jolianjij/robofield/hardware/field/out/camera_pi_mount.png

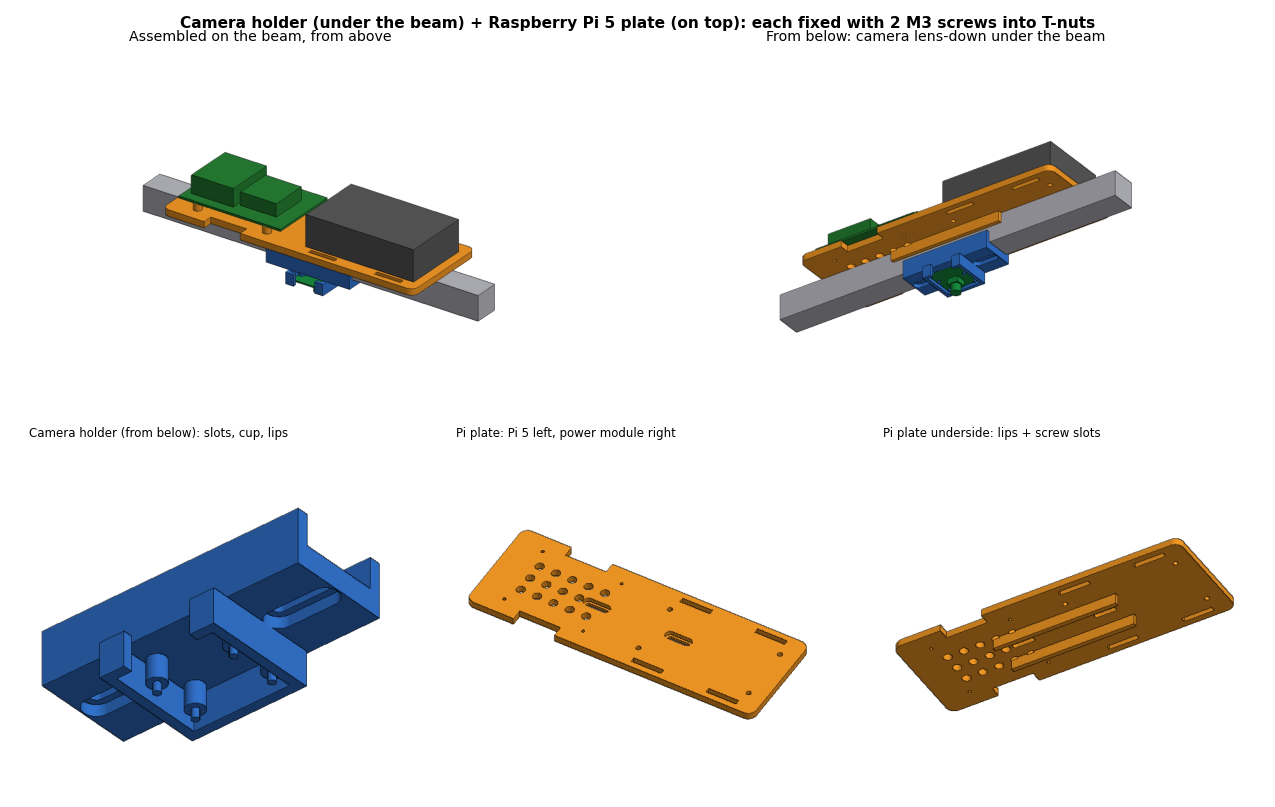
hardware/field/out/camera_pi_mount.png
