jolianjij/robofield/hardware/field/out/views_brace_anchor.png

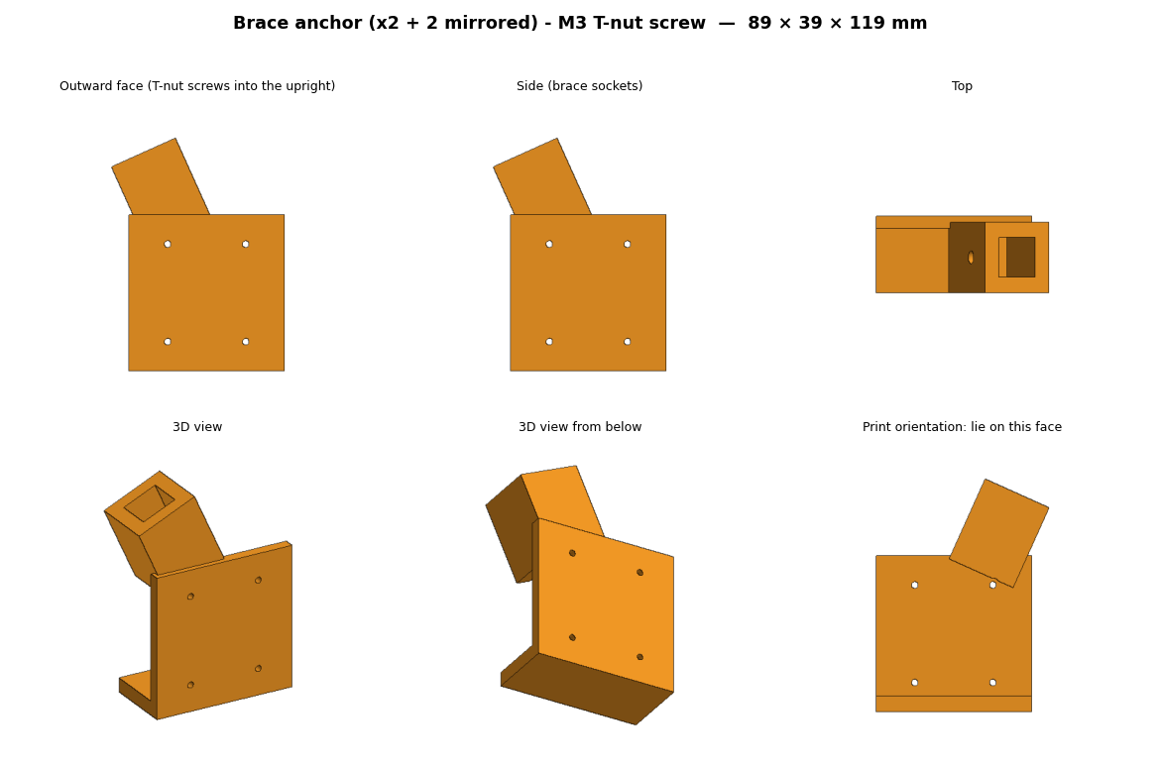
hardware/field/out/views_brace_anchor.png
