jolianjij/robofield/hardware/field/out/views_brace_clamp.png

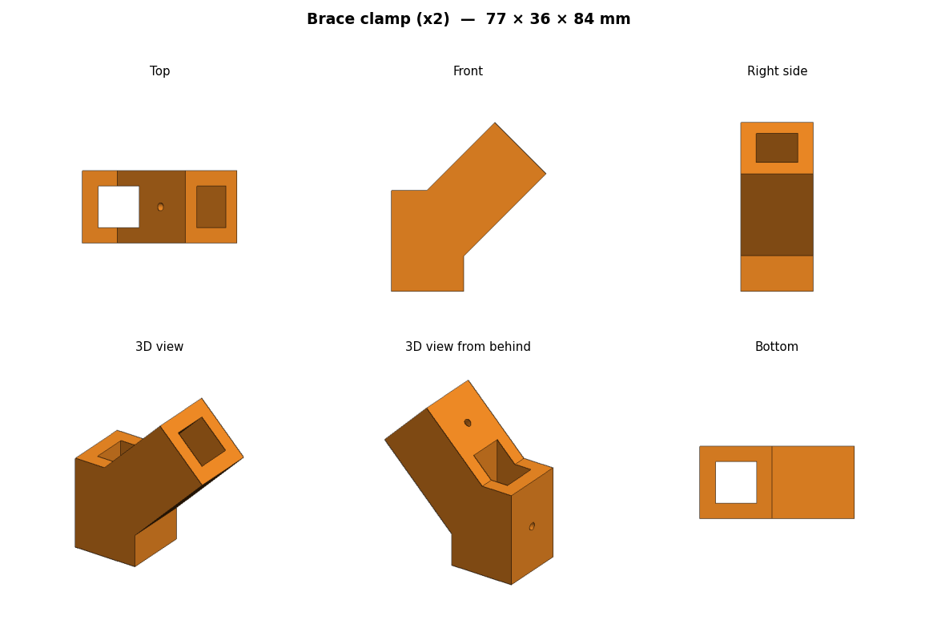
hardware/field/out/views_brace_clamp.png
