jolianjij/robofield/hardware/field/out/views_brace_clamp_double.png

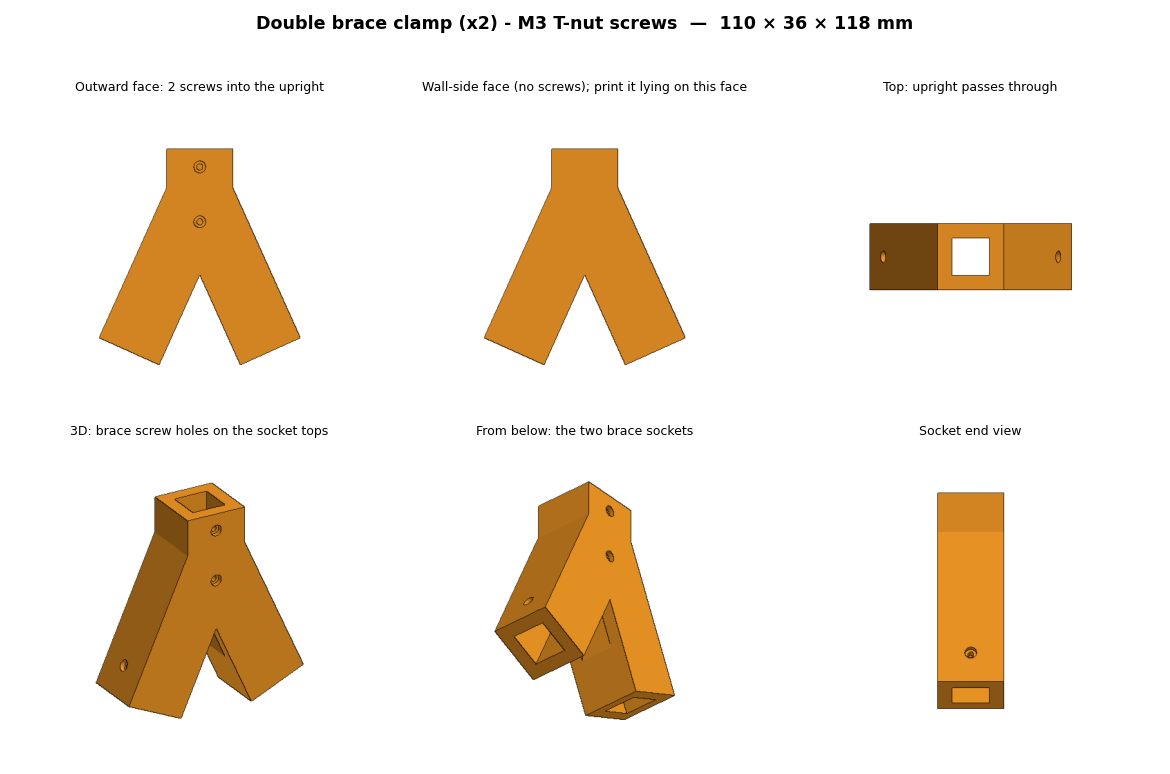
hardware/field/out/views_brace_clamp_double.png
