jolianjij/robofield/hardware/field/out/views_camera_holder.png

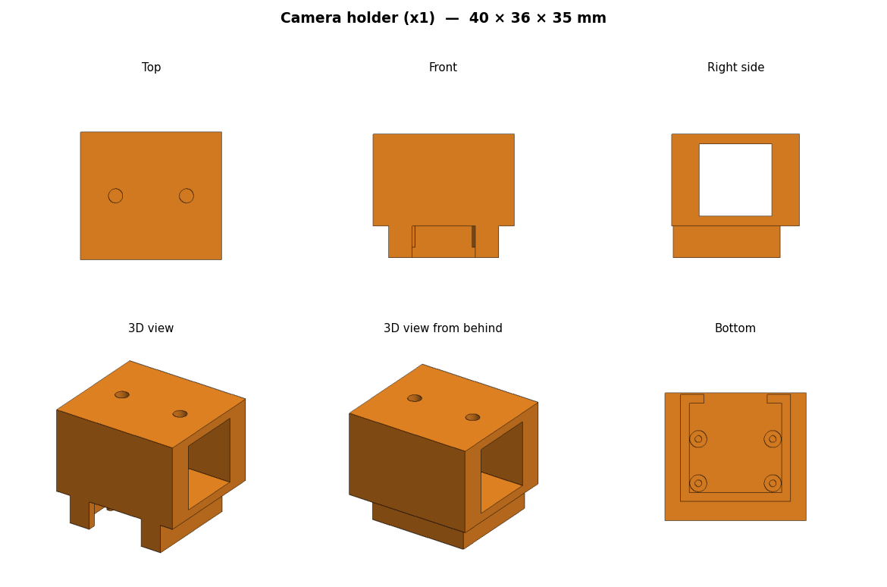
hardware/field/out/views_camera_holder.png
