jolianjij/robofield/hardware/field/out/views_mast_clamp.png

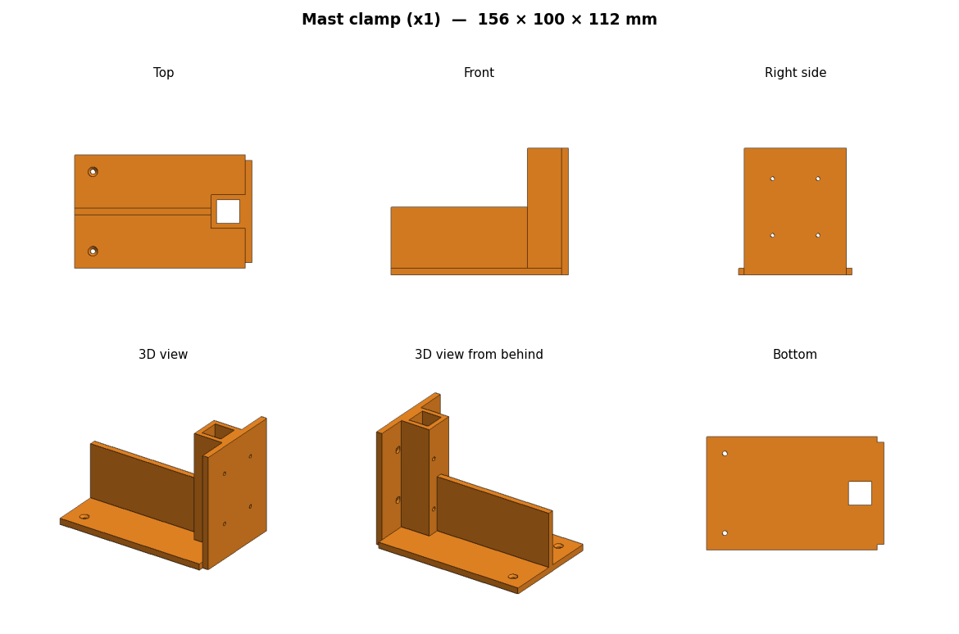
hardware/field/out/views_mast_clamp.png
