jolianjij/robofield/hardware/field/out/views_mast_clamp_tall.png

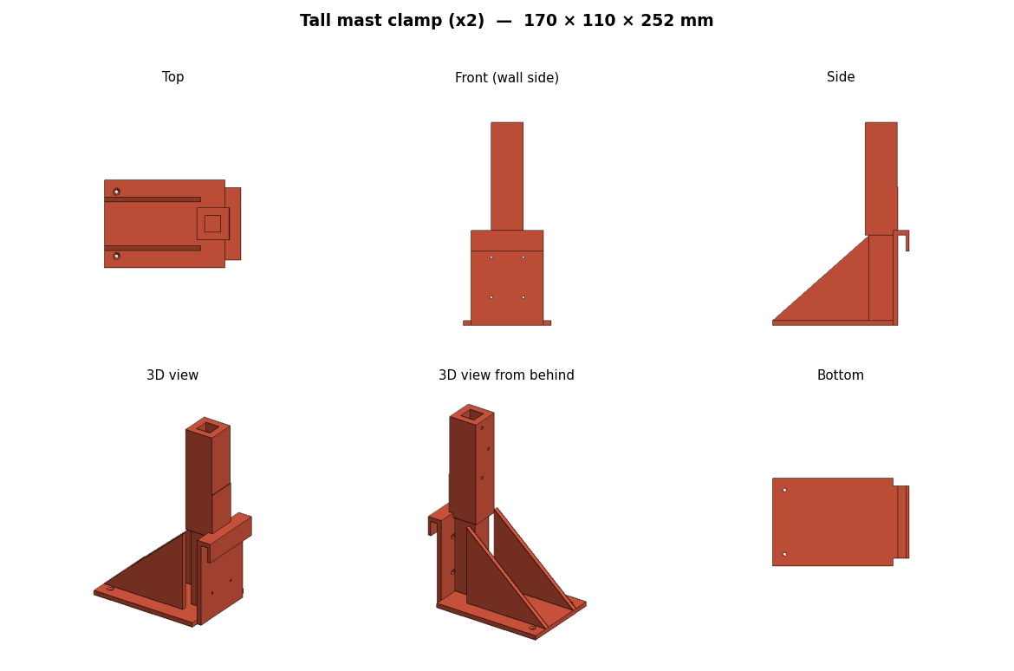
hardware/field/out/views_mast_clamp_tall.png
