jolianjij/robofield/hardware/field/out/views_splice_plate.png

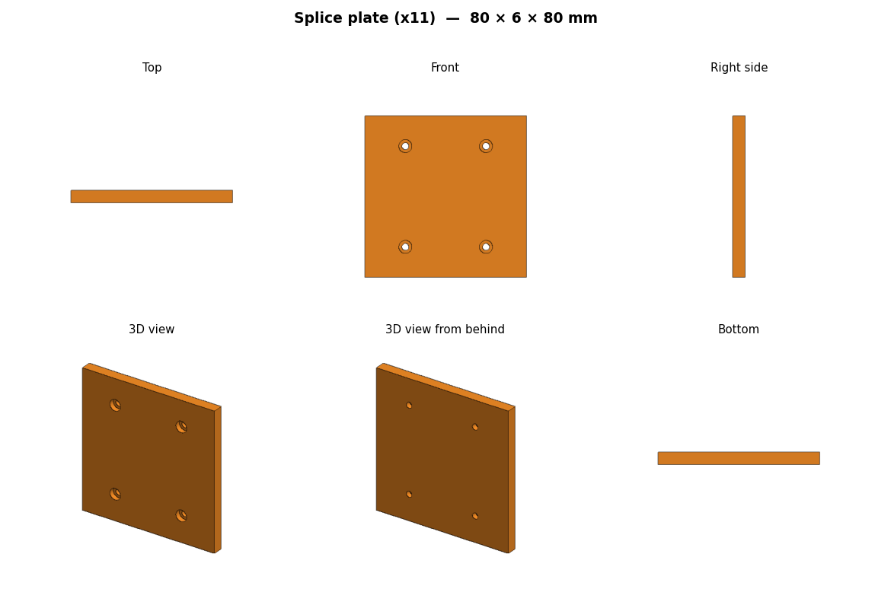
hardware/field/out/views_splice_plate.png
