jolianjij/robofield/hardware/field/out/views_tower_base.png

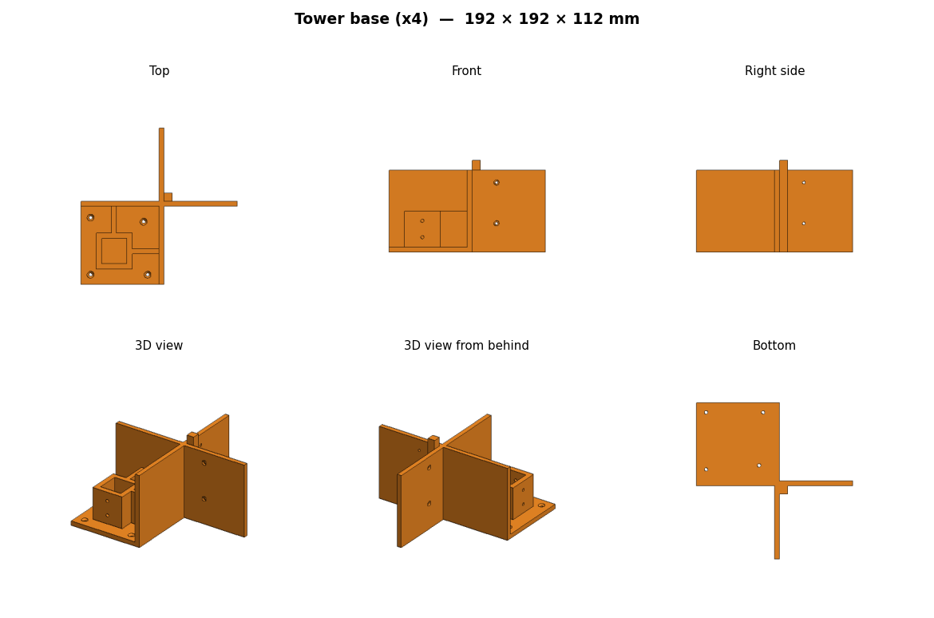
hardware/field/out/views_tower_base.png
