jolianjij/robofield/hardware/field/out/views_tower_cap.png

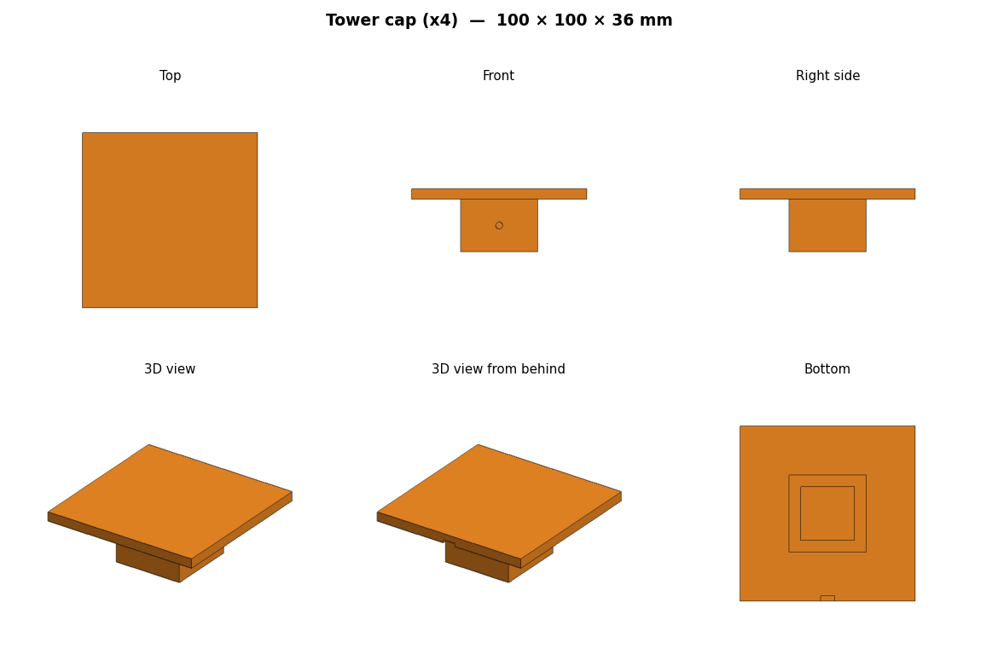
hardware/field/out/views_tower_cap.png
