jolianjij/robofield/hardware/field/out/views_wall_module.png

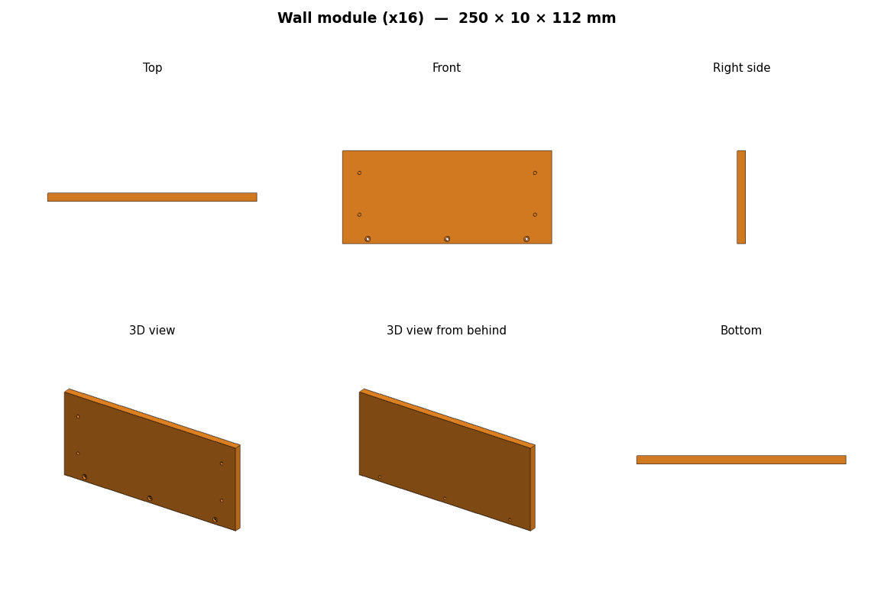
hardware/field/out/views_wall_module.png
