jolianjij/robofield/hardware/field/preview_braced_mast.png

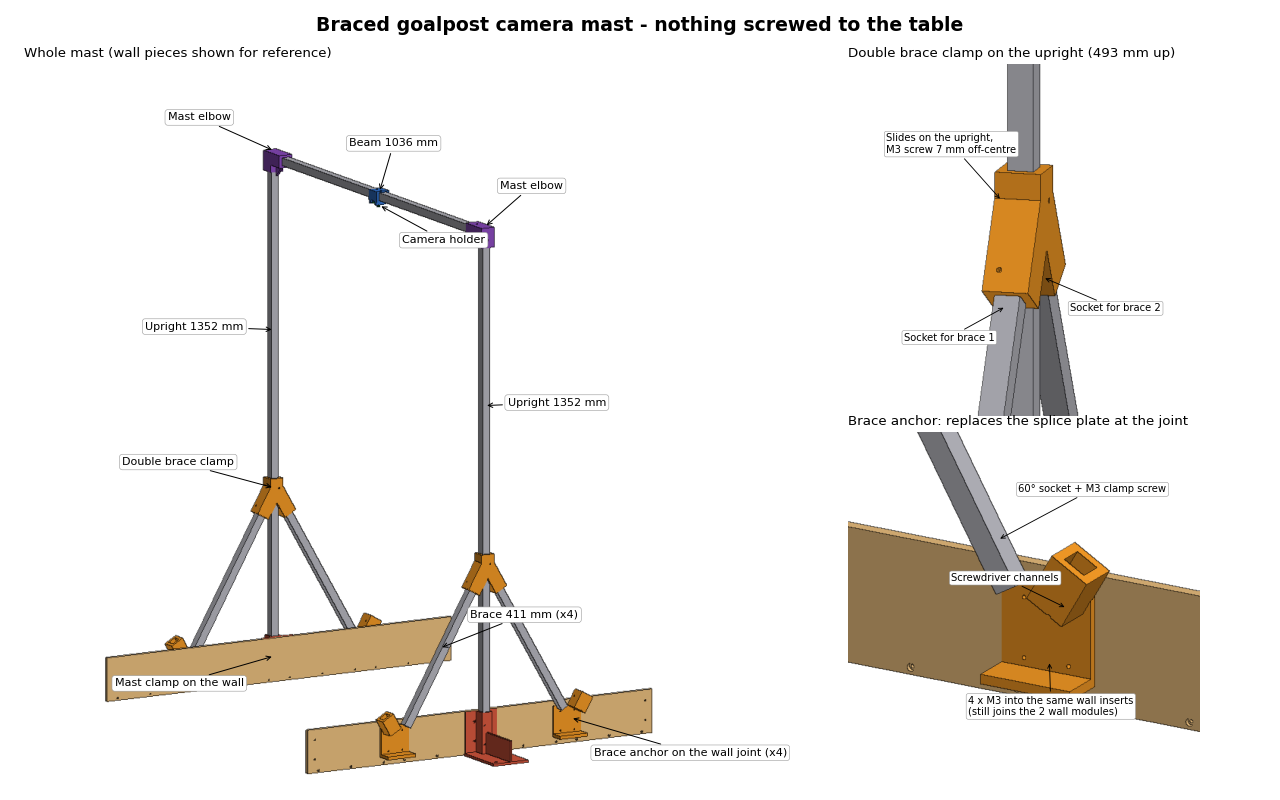
hardware/field/preview_braced_mast.png
