jolianjij/robofield/hardware/field/preview_camera_holder.png

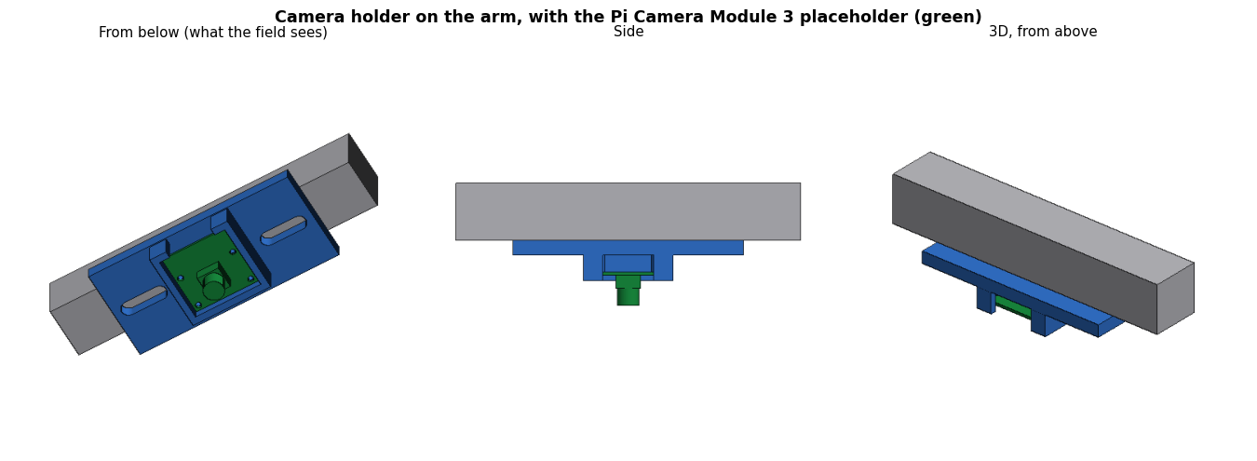
hardware/field/preview_camera_holder.png
