jolianjij/robofield/hardware/field/preview_camera_mast.png

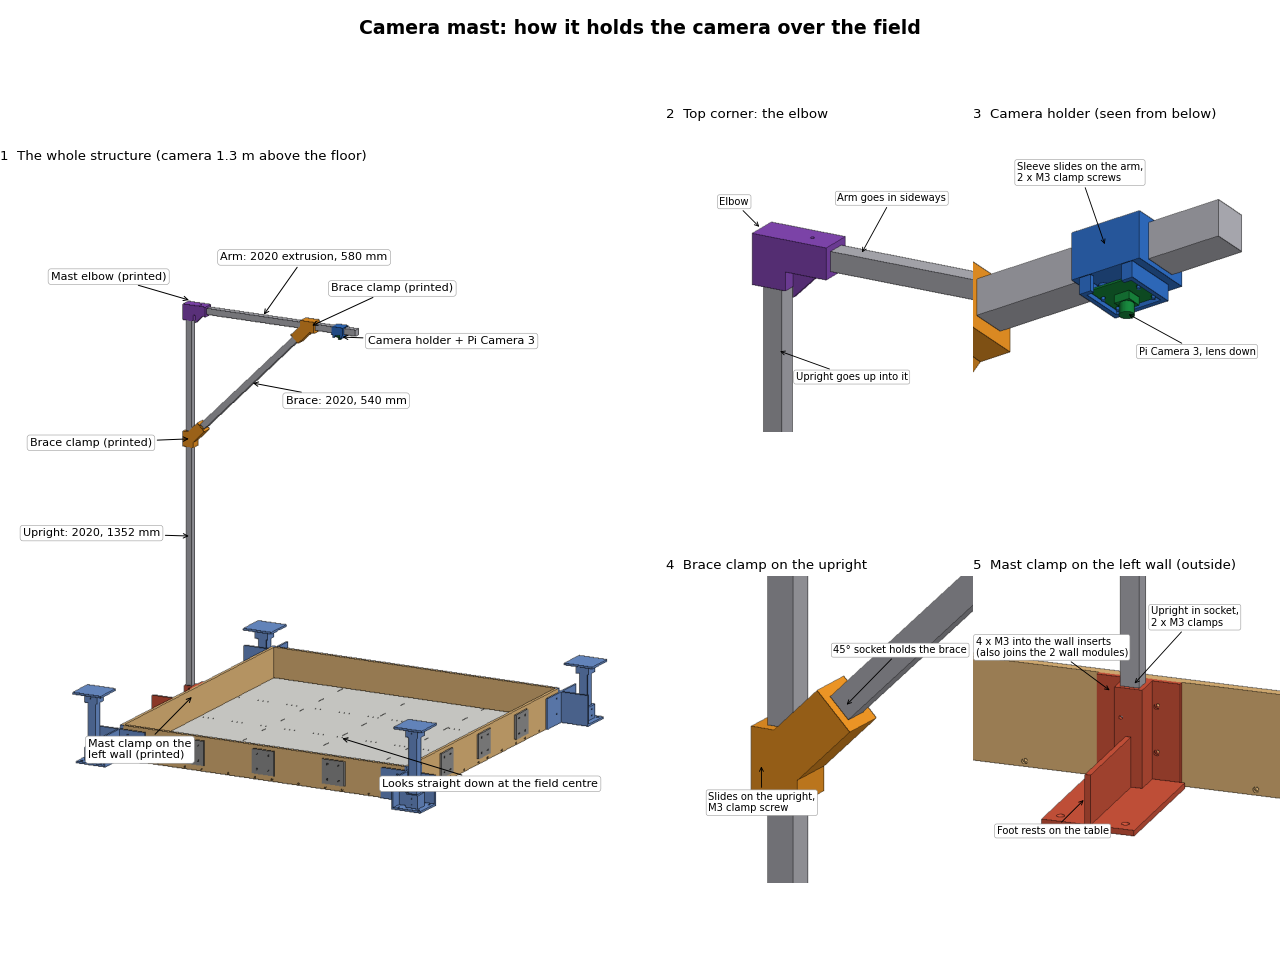
hardware/field/preview_camera_mast.png
