jolianjij/robofield/hardware/field/preview_goalpost_mast.png

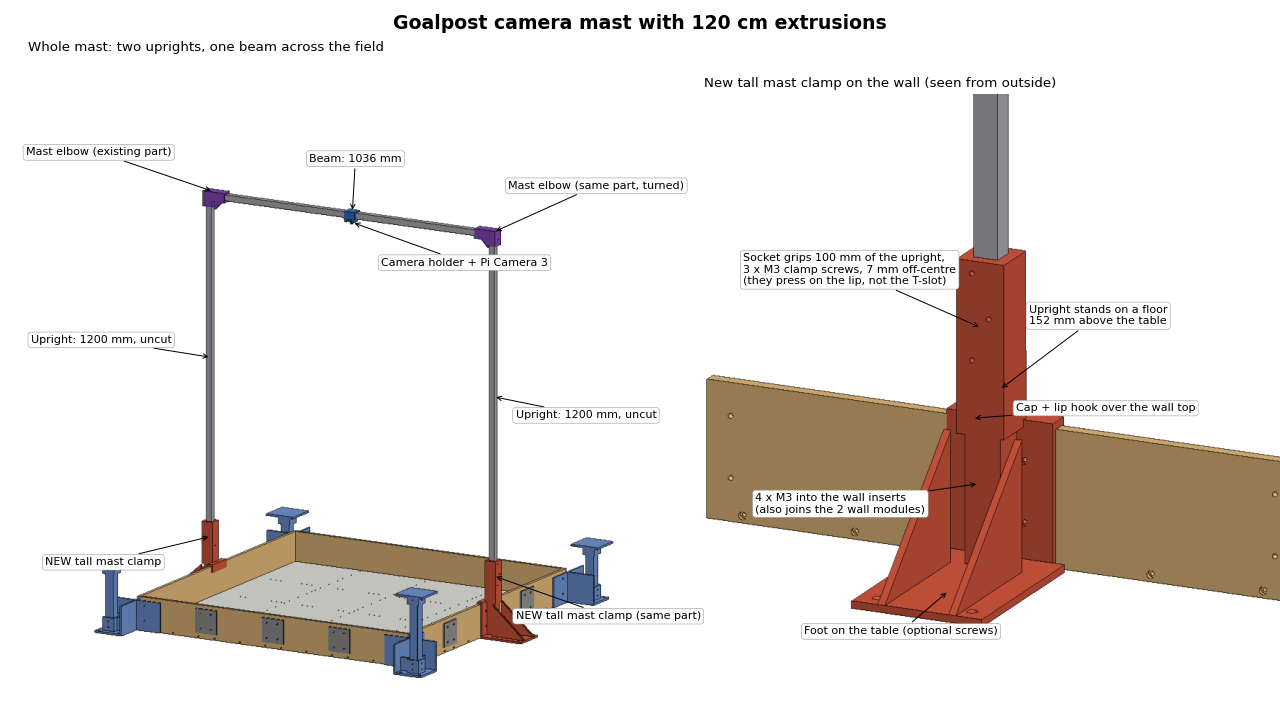
hardware/field/preview_goalpost_mast.png
