jolianjij/robofield/hardware/field/preview_mast.png

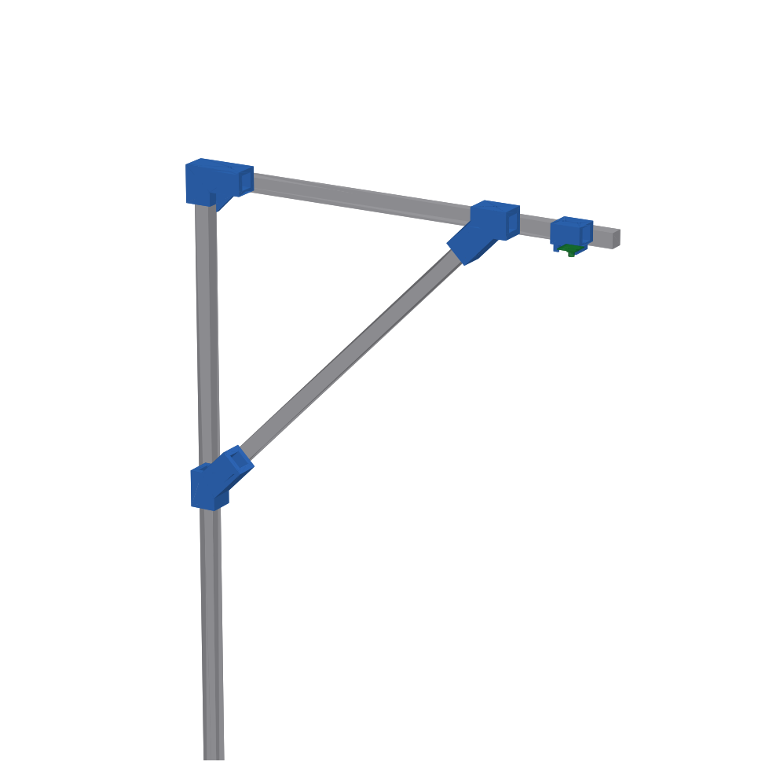
hardware/field/preview_mast.png
