jolianjij/robofield/hardware/field/preview_mast_clamp.png

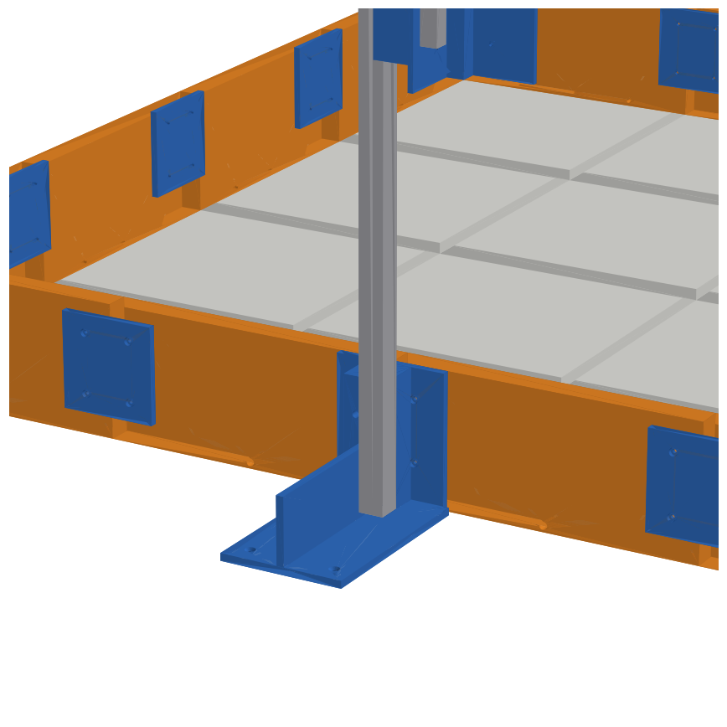
hardware/field/preview_mast_clamp.png
