jolianjij/robofield/hardware/field/preview_tower.png

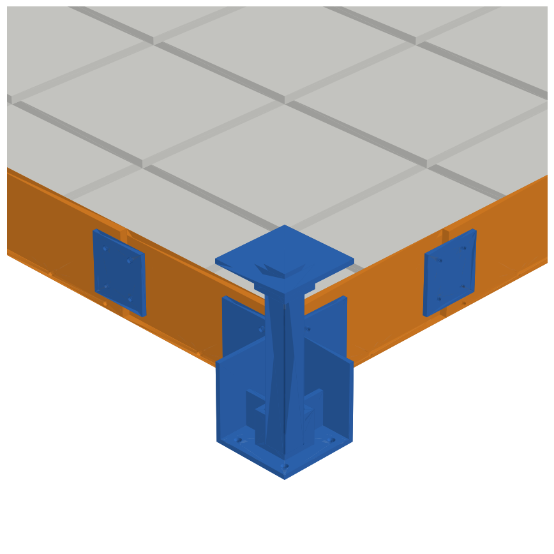
hardware/field/preview_tower.png
