jolianjij/robofield/hardware/field/out/camera_pi_mount_assembly.step

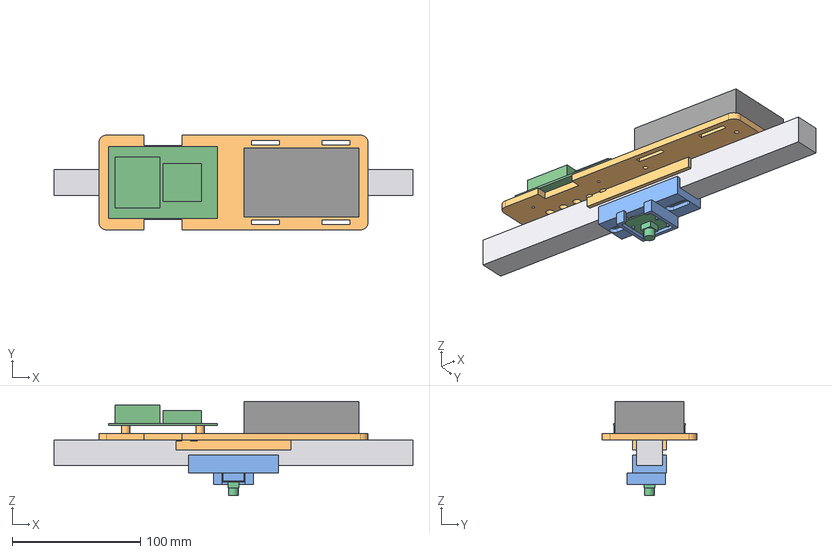
[picture p21: CAD file, 2026-11-05]
hardware/field/out/camera_pi_mount_assembly.step
280.0 x 74.0 x 73.5 mm
beam_2020
camera_holder_beam
pi_camera_module3
pi5_top_plate
pi5_spacer_-1_-1
pi5_spacer_-1_1
pi5_spacer_1_-1
pi5_spacer_1_1
raspberry_pi5_placeholder
power_module_placeholder
