jolianjij/robofield/hardware/field/out/mast_goalpost_assembly.step

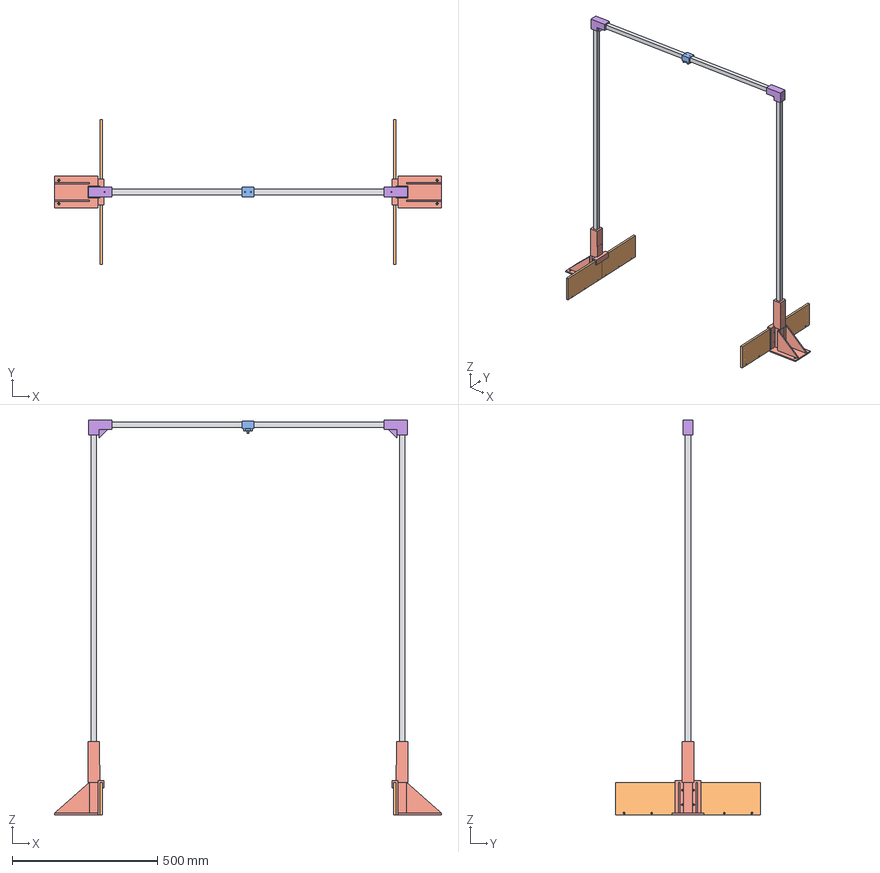
[picture p22: CAD file, 2026-11-05]
hardware/field/out/mast_goalpost_assembly.step
1332.0 x 500.0 x 1358.5 mm
wall_left_ref_a
wall_left_ref_b
wall_right_ref_a
wall_right_ref_b
mast_clamp_tall_left
mast_clamp_tall_right
upright_left_1200mm
upright_right_1200mm
mast_elbow_left
mast_elbow_right
beam_1036mm
camera_holder
camera_placeholder
