jolianjij/robofield/hardware/field/out/mast_braced_assembly.step

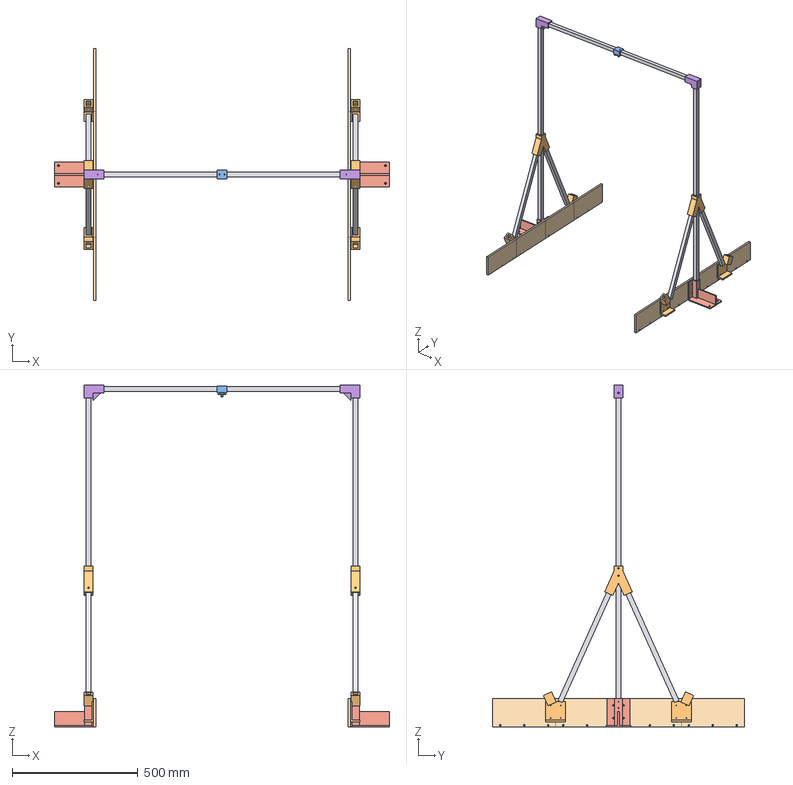
[picture p23: CAD file, 2026-11-05]
hardware/field/out/mast_braced_assembly.step
1332.0 x 1000.0 x 1358.5 mm
wall_ref_0
wall_ref_1
wall_ref_2
wall_ref_3
wall_ref_4
wall_ref_5
wall_ref_6
wall_ref_7
mast_clamp_left
mast_clamp_right
upright_left_1352mm
upright_right_1352mm
mast_elbow_left
mast_elbow_right
beam_1036mm
camera_holder
camera_placeholder
brace_clamp_double_left
brace_anchor_left_y250
brace_left_y250_505mm
brace_anchor_left_y750
brace_left_y750_505mm
brace_clamp_double_right
brace_anchor_right_y250
brace_right_y250_505mm
brace_anchor_right_y750
brace_right_y750_505mm
