jolianjij/robofield/hardware/field/out/field_assembly.step

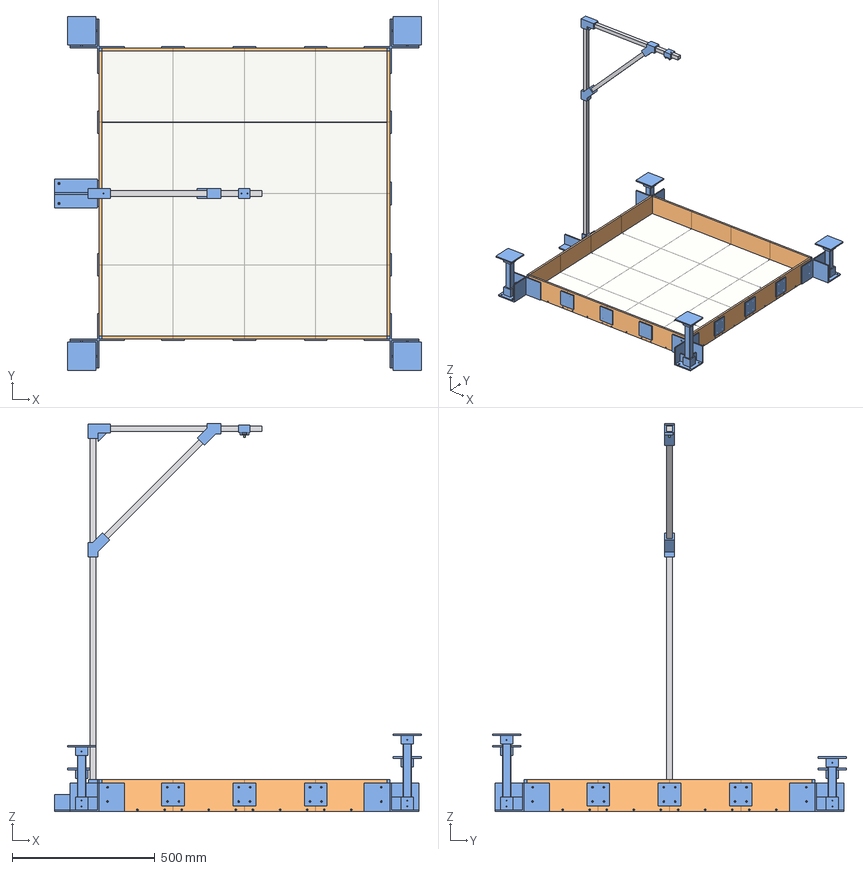
[picture p24: CAD file, 2026-11-05]
hardware/field/out/field_assembly.step
1287.0 x 1242.0 x 1360.5 mm
tile_00
tile_01
tile_02
tile_03
tile_10
tile_11
tile_12
tile_13
tile_20
tile_21
tile_22
tile_23
tile_30
tile_31
tile_32
tile_33
wall_bottom_0
wall_top_0
wall_left_0
wall_right_0
wall_bottom_1
wall_top_1
wall_left_1
wall_right_1
wall_bottom_2
wall_top_2
wall_left_2
wall_right_2
wall_bottom_3
wall_top_3
wall_left_3
wall_right_3
splice_bottom_1
splice_top_1
splice_right_1
splice_left_1
splice_bottom_2
splice_top_2
splice_right_2
splice_bottom_3
splice_top_3
splice_right_3
splice_left_3
T3_base
T3_column_220mm
T3_cap
T4_base
T4_column_260mm
T4_cap
T2_base
T2_column_180mm
T2_cap
T1_base
T1_column_140mm
T1_cap
mast_clamp
mast_upright_2020_1352mm
mast_arm_2020_580mm
mast_elbow
brace_clamp_upright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
