jolianjij/robofield/hardware/field/field_tile_key.step

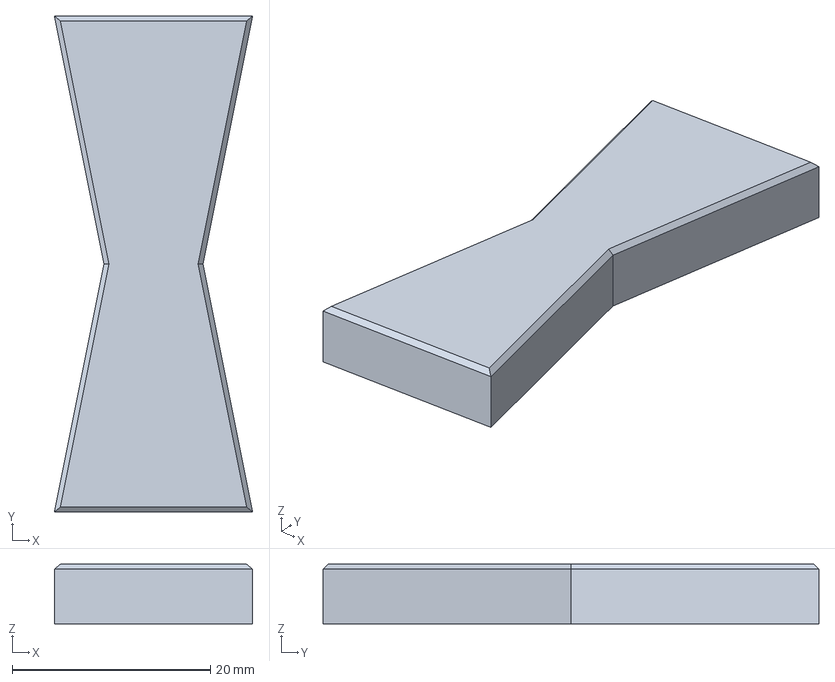
[picture p25: CAD file, 2026-11-05]
hardware/field/field_tile_key.step
20.0 x 50.0 x 6.00 mm
