jolianjij/robofield/hardware/field/out/brace_anchor.step

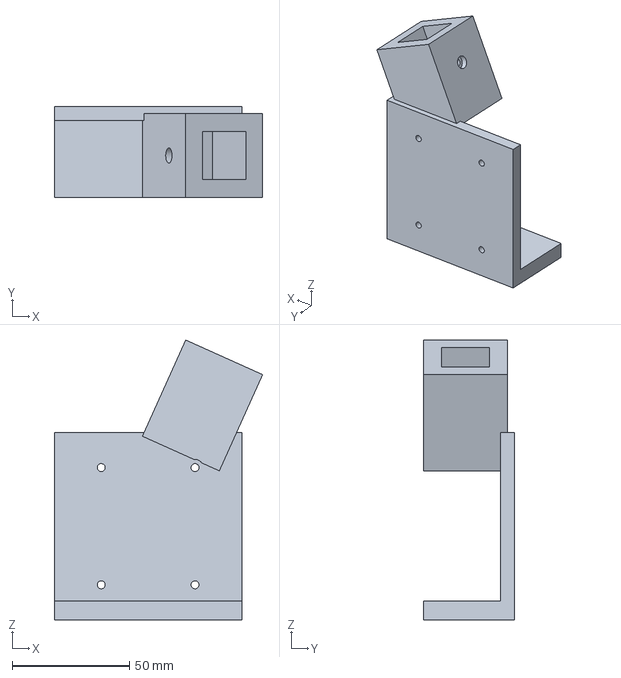
[picture p26: CAD file, 2026-11-05]
hardware/field/out/brace_anchor.step
88.8 x 39.0 x 119.4 mm
