jolianjij/robofield/hardware/field/field_tile_250mm.step

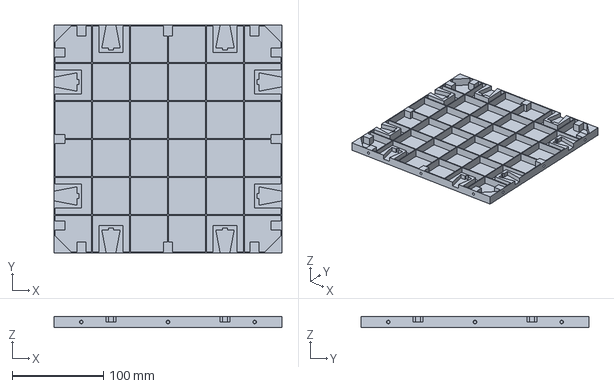
[picture p27: CAD file, 2026-11-05]
hardware/field/field_tile_250mm.step
250.0 x 250.0 x 12.0 mm
