jolianjij/robofield/hardware/field/out/2020_goalpost_beam_1036mm.step

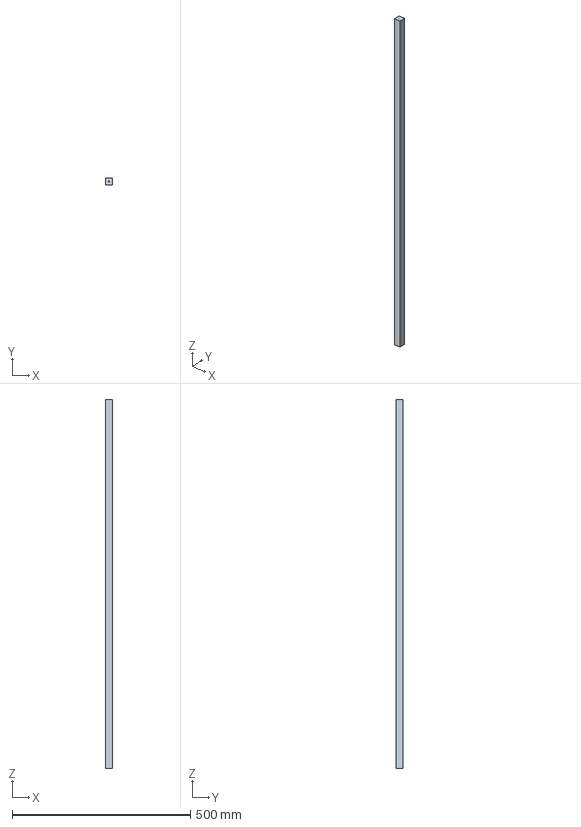
[picture p28: CAD file, 2026-11-05]
hardware/field/out/2020_goalpost_beam_1036mm.step
20.0 x 20.0 x 1036.0 mm
