jolianjij/robofield/hardware/field/field_tile_edge_test_strip.step

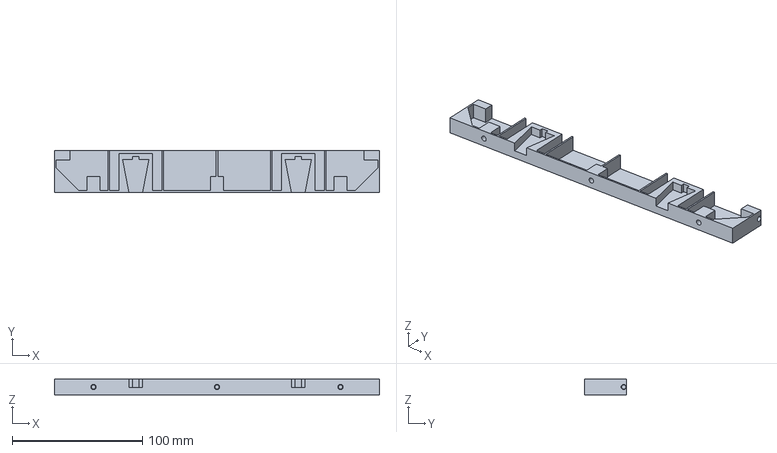
[picture p29: CAD file, 2026-11-05]
hardware/field/field_tile_edge_test_strip.step
250.0 x 32.0 x 12.0 mm
