jolianjij/robofield/hardware/field/out/splice_plate.step

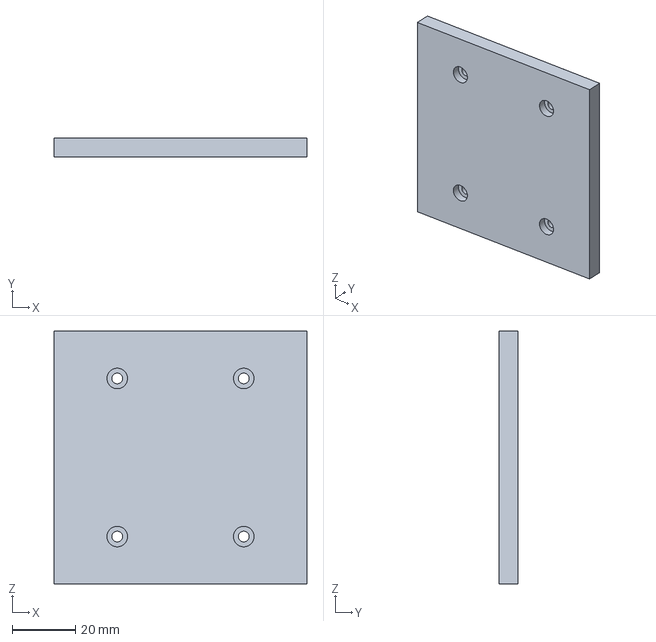
[picture p30: CAD file, 2026-11-05]
hardware/field/out/splice_plate.step
80.0 x 6.00 x 80.0 mm
