jolianjij/robofield/hardware/field/out/2020_goalpost_upright_1200mm.step

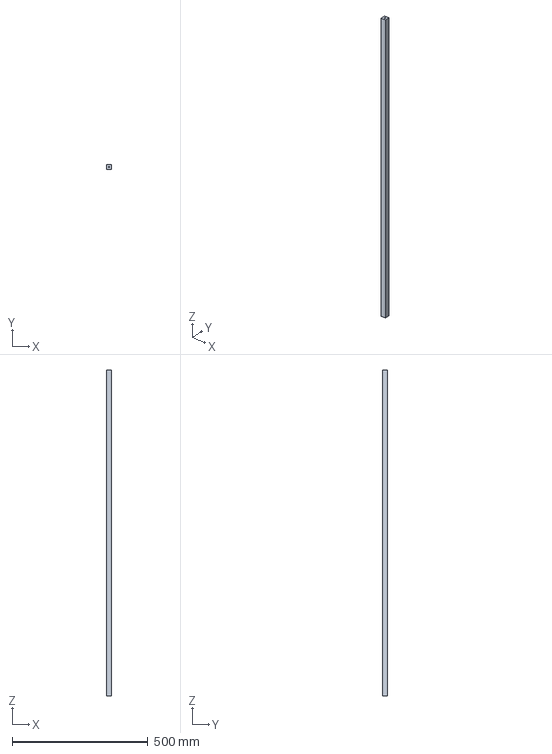
[picture p31: CAD file, 2026-11-05]
hardware/field/out/2020_goalpost_upright_1200mm.step
20.0 x 20.0 x 1200.0 mm
