jolianjij/robofield/hardware/field/out/mast_clamp.step

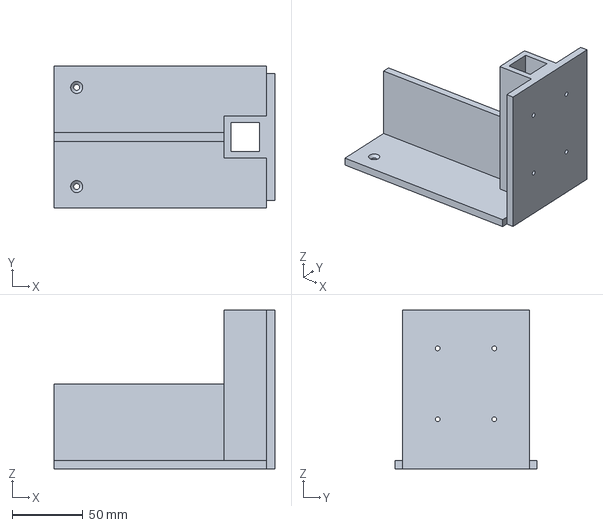
[picture p32: CAD file, 2026-11-05]
hardware/field/out/mast_clamp.step
156.0 x 100.0 x 112.0 mm
