jolianjij/robofield/hardware/field/out/tower_column_T4_260mm.step

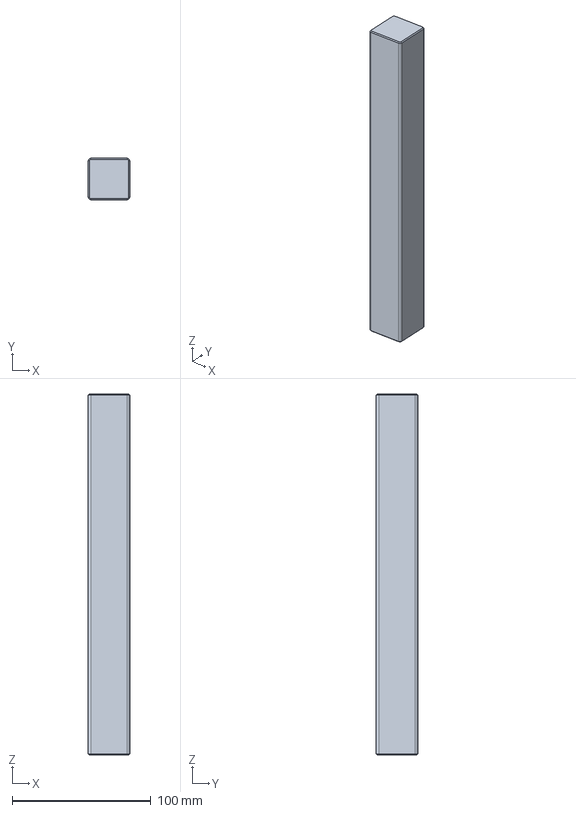
[picture p33: CAD file, 2026-11-05]
hardware/field/out/tower_column_T4_260mm.step
30.0 x 30.0 x 260.0 mm
