jolianjij/robofield/hardware/field/out/2020_upright_1352mm.step

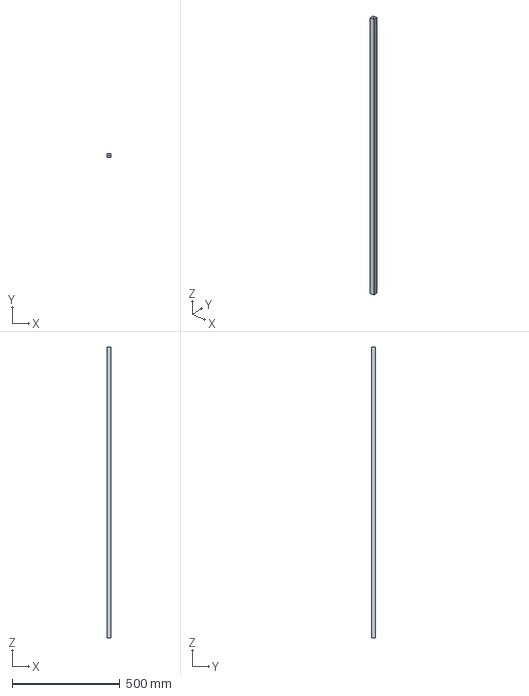
[picture p34: CAD file, 2026-11-05]
hardware/field/out/2020_upright_1352mm.step
20.0 x 20.0 x 1352.5 mm
