jolianjij/robofield/hardware/field/out/tower_column_T1_140mm.step

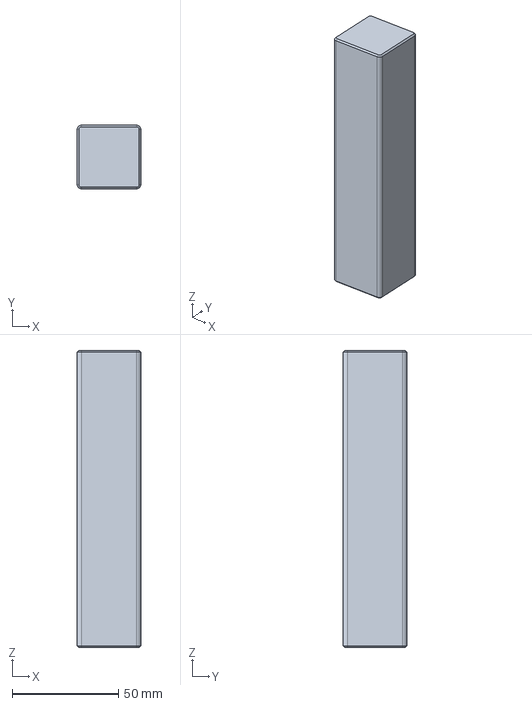
[picture p35: CAD file, 2026-11-05]
hardware/field/out/tower_column_T1_140mm.step
30.0 x 30.0 x 140.0 mm
