jolianjij/robofield/hardware/field/out/mast_elbow.step

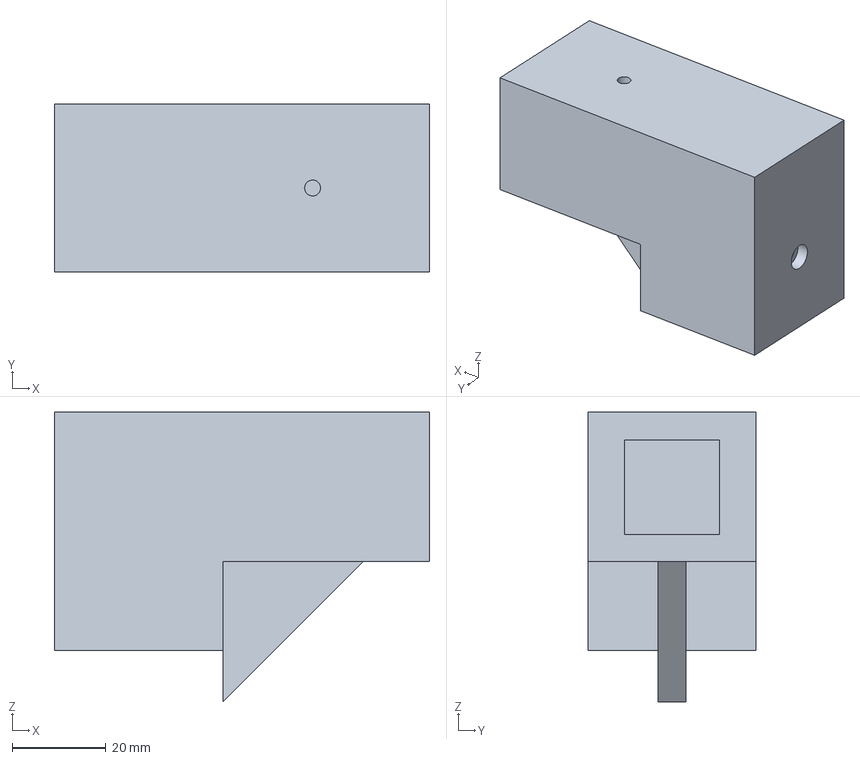
[picture p36: CAD file, 2026-11-05]
hardware/field/out/mast_elbow.step
80.2 x 36.0 x 62.0 mm
