jolianjij/robofield/hardware/field/out/brace_clamp_double.step

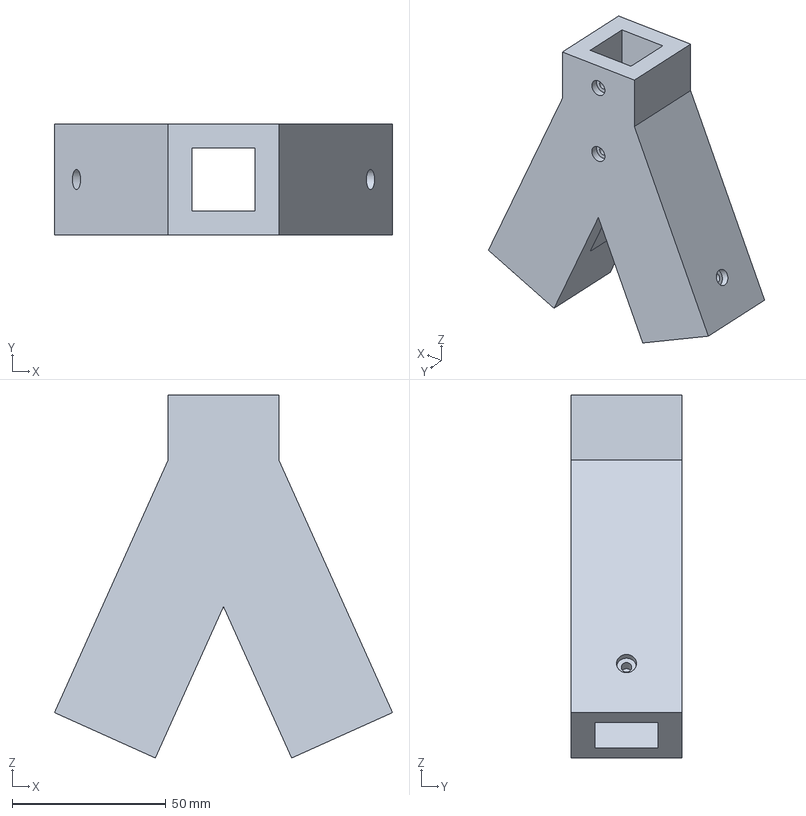
[picture p37: CAD file, 2026-11-05]
hardware/field/out/brace_clamp_double.step
110.0 x 36.0 x 118.1 mm
