jolianjij/robofield/hardware/field/out/camera_holder.step

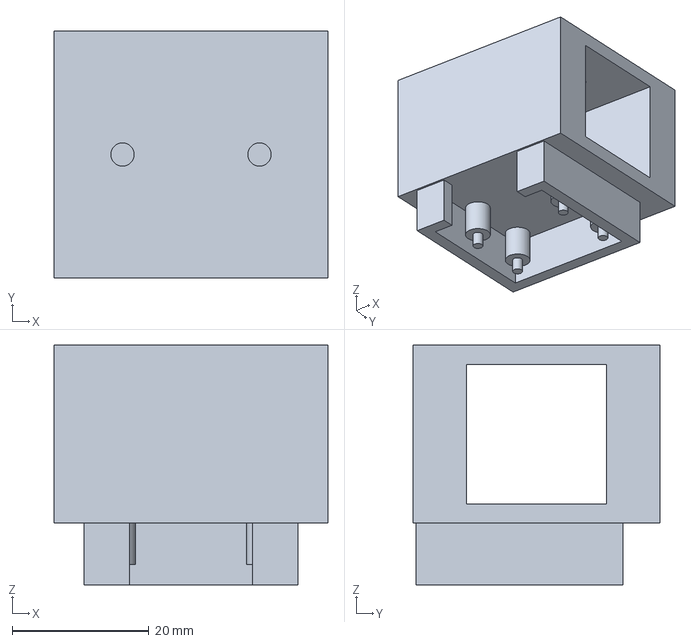
[picture p38: CAD file, 2026-11-05]
hardware/field/out/camera_holder.step
40.0 x 36.0 x 35.0 mm
