jolianjij/robofield/hardware/field/out/2020_brace_505mm.step

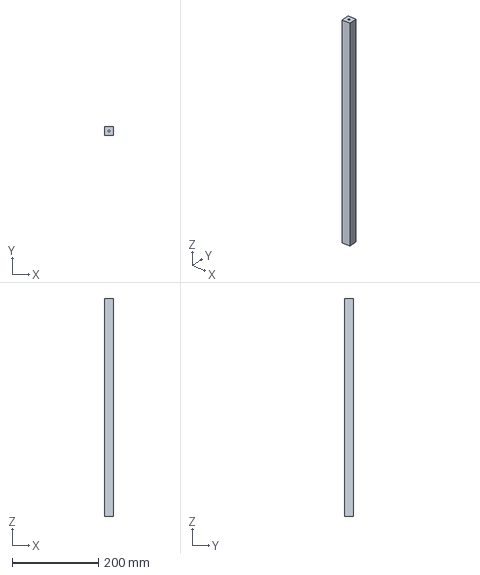
[picture p39: CAD file, 2026-11-05]
hardware/field/out/2020_brace_505mm.step
20.0 x 20.0 x 505.0 mm
