jolianjij/robofield/hardware/field/out/mast_clamp_tall.step

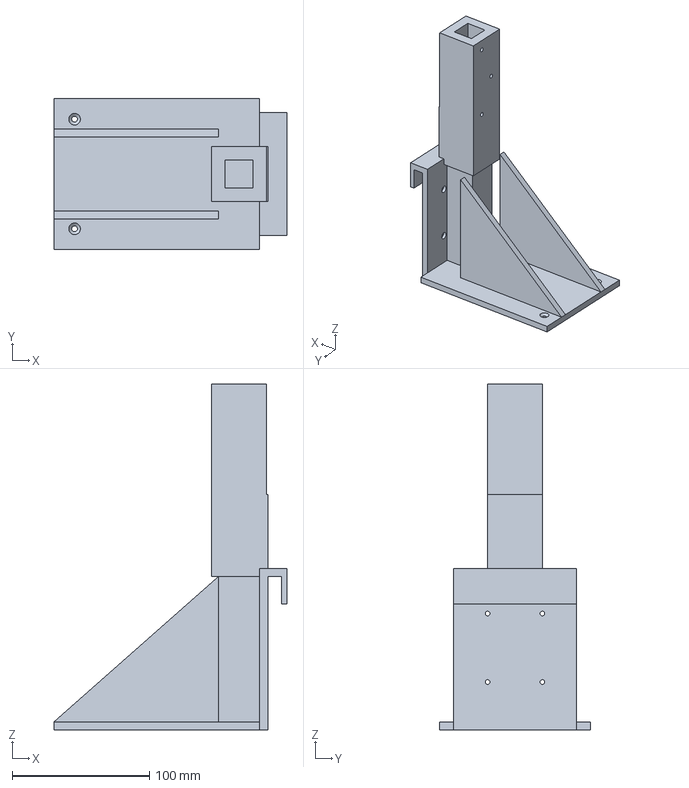
[picture p40: CAD file, 2026-11-05]
hardware/field/out/mast_clamp_tall.step
170.0 x 110.0 x 252.5 mm
