jolianjij/robofield/hardware/field/out/tower_cap.step

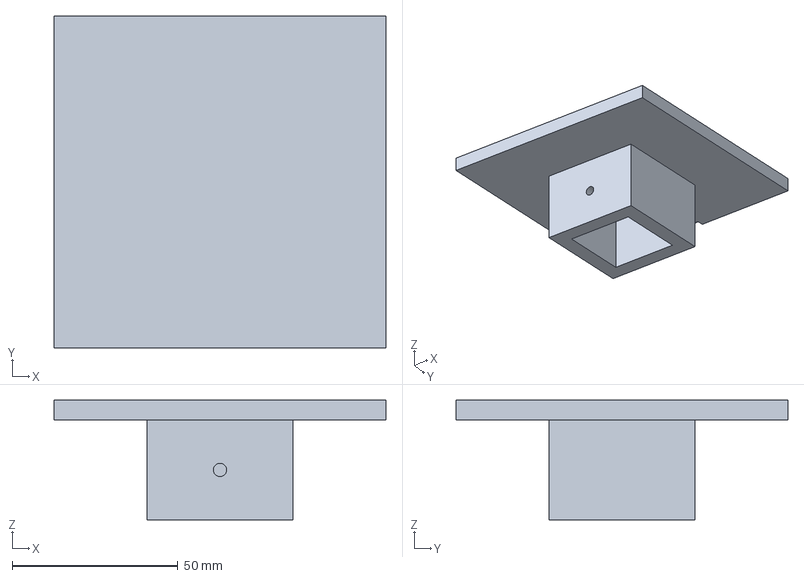
[picture p41: CAD file, 2026-11-05]
hardware/field/out/tower_cap.step
100.0 x 100.0 x 36.0 mm
