jolianjij/robofield/hardware/field/out/pi5_top_plate.step

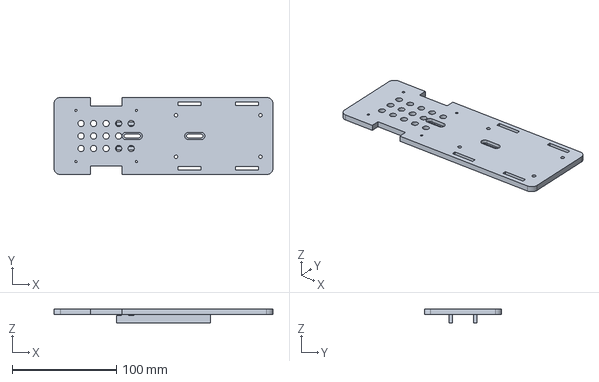
[picture p42: CAD file, 2026-11-05]
hardware/field/out/pi5_top_plate.step
210.0 x 74.0 x 13.0 mm
