jolianjij/robofield/hardware/field/out/wall_module.step

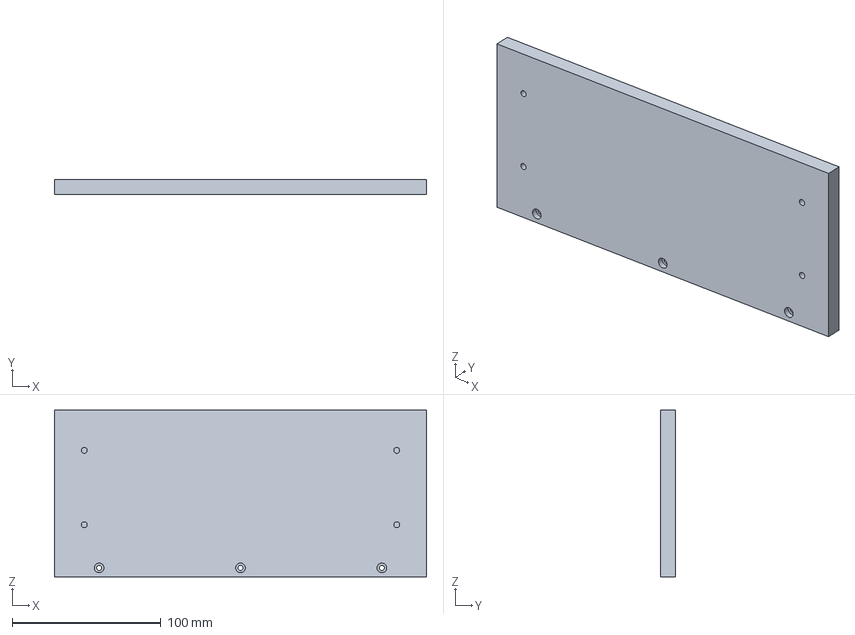
[picture p43: CAD file, 2026-11-05]
hardware/field/out/wall_module.step
250.0 x 10.0 x 112.0 mm
