jolianjij/robofield/hardware/field/out/tower_column_T2_180mm.step

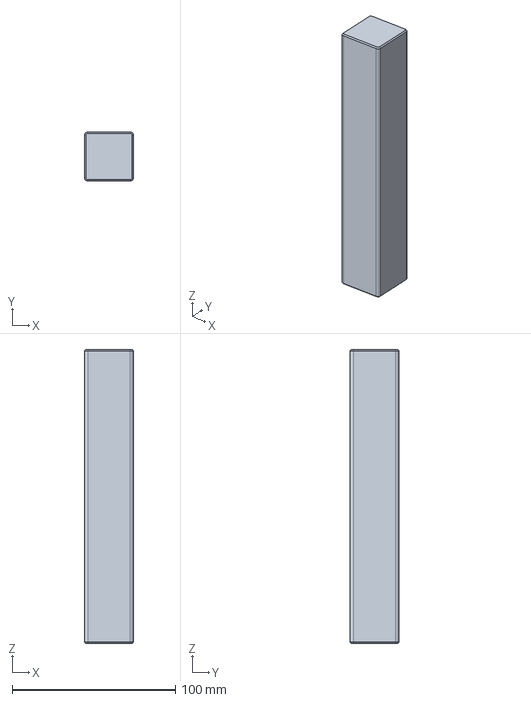
[picture p44: CAD file, 2026-11-05]
hardware/field/out/tower_column_T2_180mm.step
30.0 x 30.0 x 180.0 mm
