jolianjij/robofield/hardware/field/out/pi5_spacer.step

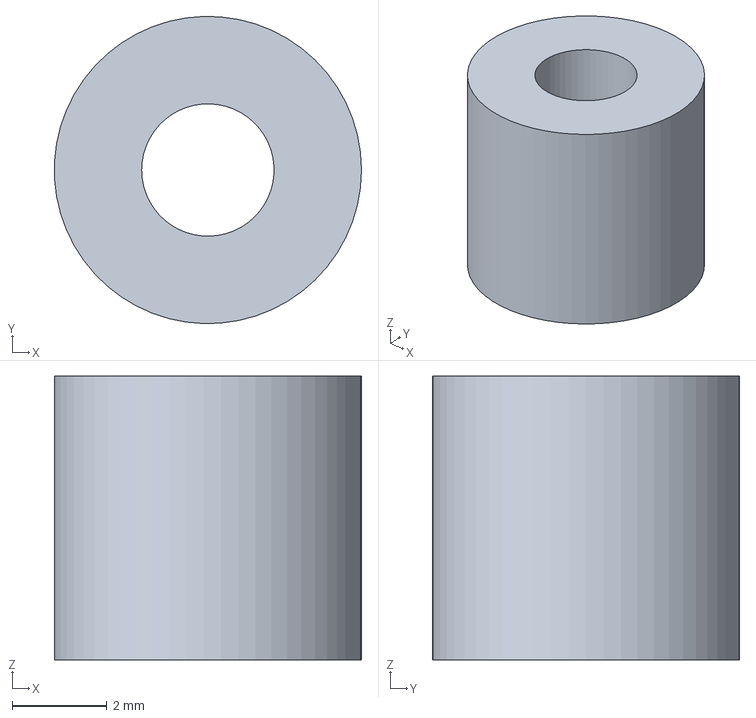
[picture p45: CAD file, 2026-11-05]
hardware/field/out/pi5_spacer.step
6.49 x 6.50 x 6.00 mm
