jolianjij/robofield/hardware/field/out/brace_clamp.step

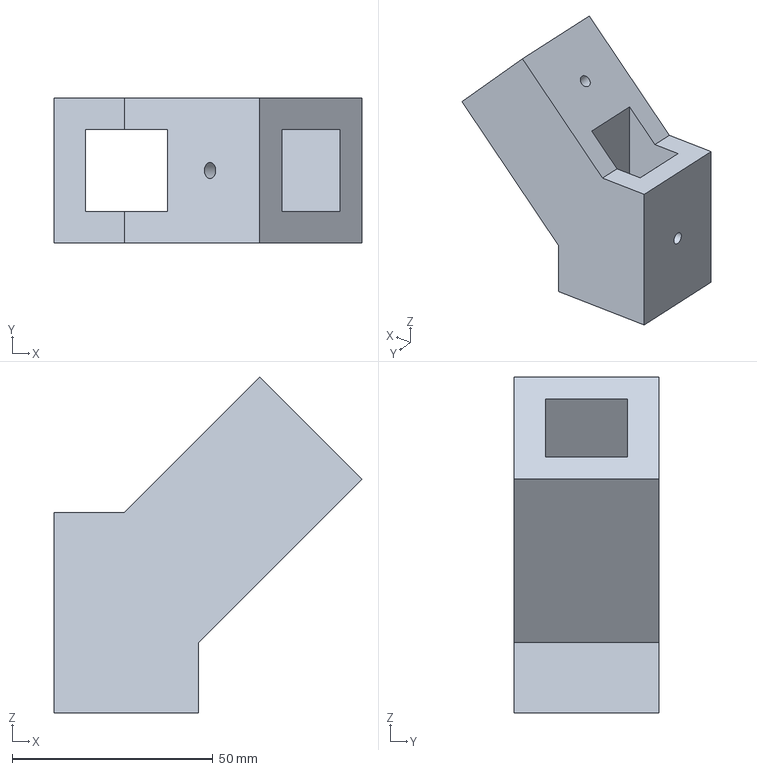
[picture p46: CAD file, 2026-11-05]
hardware/field/out/brace_clamp.step
76.7 x 36.0 x 83.7 mm
