jolianjij/robofield/hardware/field/out/camera_pi_module3_placeholder.step

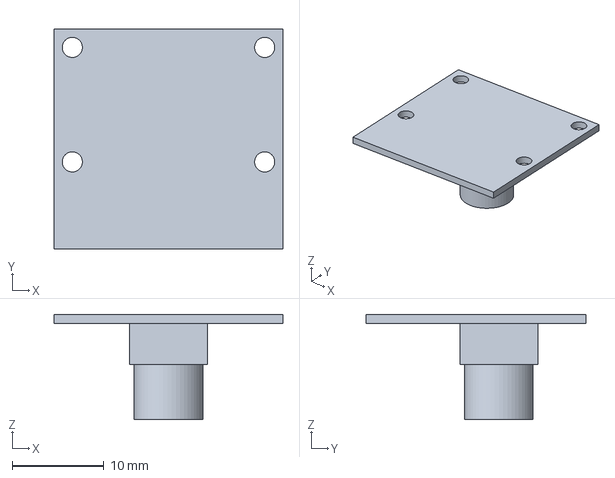
[picture p47: CAD file, 2026-11-05]
hardware/field/out/camera_pi_module3_placeholder.step
25.0 x 24.0 x 11.5 mm
