jolianjij/robofield/hardware/field/out/tower_column_T3_220mm.step

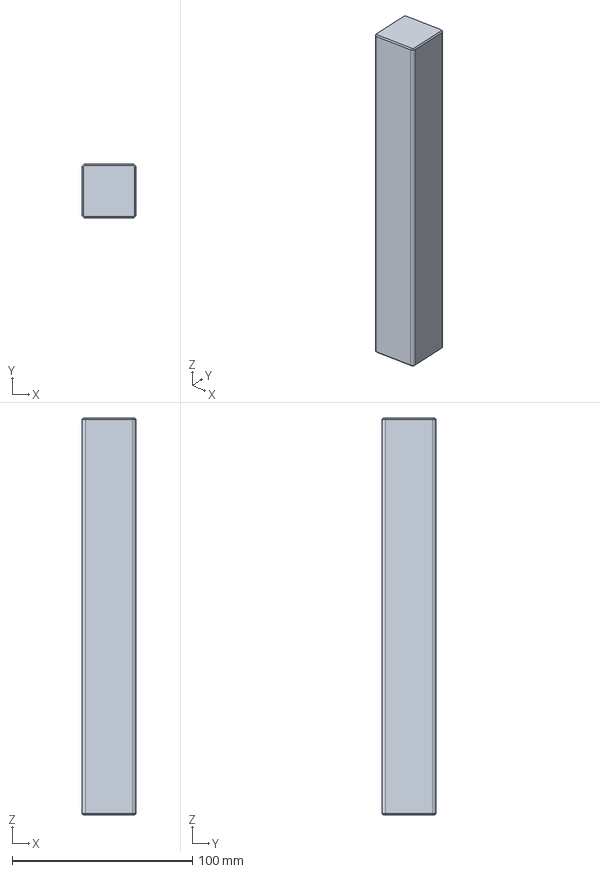
[picture p48: CAD file, 2026-11-05]
hardware/field/out/tower_column_T3_220mm.step
30.0 x 30.0 x 220.0 mm
