jolianjij/robofield/hardware/field/out/camera_holder_beam.step

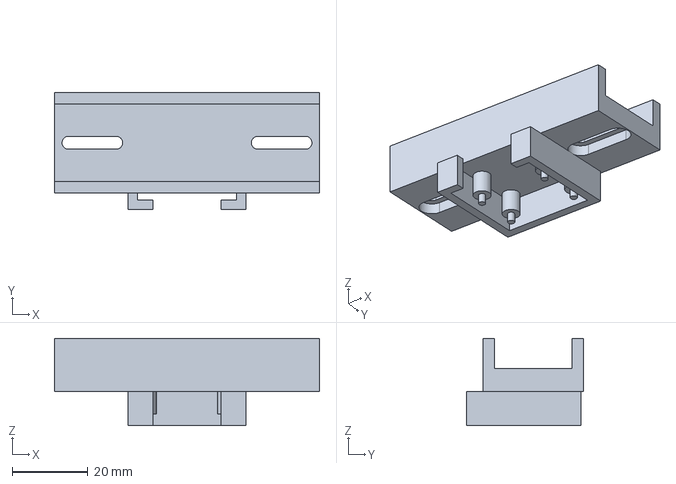
[picture p49: CAD file, 2026-11-05]
hardware/field/out/camera_holder_beam.step
70.0 x 30.9 x 23.0 mm
