jolianjij/robofield/hardware/field/out/tower_base.step

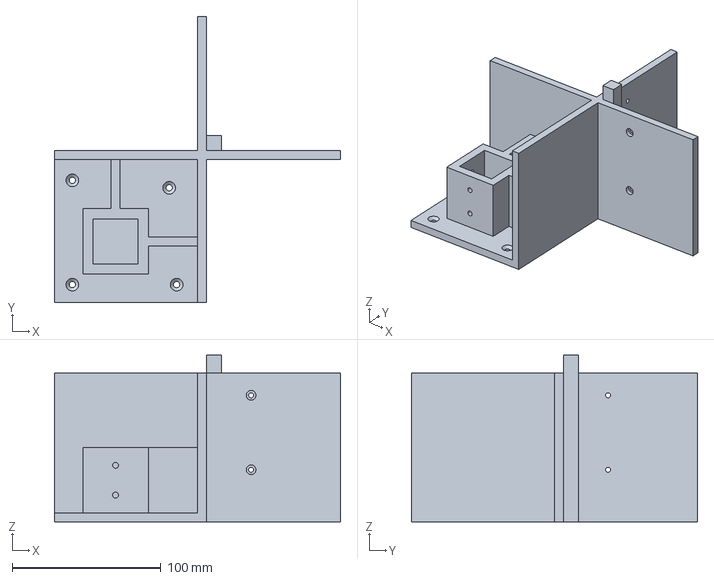
[picture p50: CAD file, 2026-11-05]
hardware/field/out/tower_base.step
192.0 x 192.0 x 112.0 mm
