jolianjij/robofield/(list of files, cad)

Other CAD files:
hardware/field/out/2020_beam_1036mm.step
hardware/field/out/brace_anchor_mirrored.step
hardware/field/field_tile_250mm.stl
hardware/field/field_tile_edge_test_strip.stl
hardware/field/field_tile_key.stl
