jolianjij/robofield/(commit log)

2026-11-05 Initial commit: RoboField/RLCR multi-robot research platform
    Add project context (CLAUDE.md) documenting the real hardware state
    (ESP8266/D1 Mini + DRV8833, replacing the original ESP32-C3/L9110S
    design) and current software stack.
    [2020_beam_1036mm.step, 2020_brace_505mm.step, 2020_goalpost_beam_1036mm.step, 2020_goalpost_upright_1200mm.step, 2020_upright_1352mm.step, brace_anchor.step, brace_anchor_mirrored.step, brace_clamp.step]
2026-11-05 Fix DiffDrive turn-direction sign bug; add PID control, race game, and RL training
    DiffDrive.inverse() had its left/right wheel formulas swapped relative to
    forward(), so every commanded turn rate produced physical rotation in the
    opposite direction. This is the real cause of the "violent oscillation"
    reaching a target orientation: a closed-loop heading controller with an
    inverted sign reinforces whatever rotation already exists instead of
    opposing it, which looks exactly like an undampable limit cycle no matter
    how the gains are tuned. Confirmed against the real car's behavior.
    Also:
    - Enable reverse driving on the final approach and path-following (was
    hardcoded off in PoseController)
    -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
    [field.yaml]
2026-11-06 Turn by pulse-wait-measure pivots; add evaluation and demo tools
    Turning in place on the real car needs a hard kick to break both wheels
    free sideways, then coasts far past the target, so fine corrections were
    impossible and predicted-heading turns stalled short. Turns are now
    single-wheel pivot pulses sized by a learned start-time/turn-rate model,
    each followed by a wait longer than the loop delay before re-measuring.
    Real car: 120 deg turns in ~4 s to within 2-5 deg, no oscillation.
    - tools/eval_motion.py: score straight, turn and curve maneuvers
    - tools/demo.py: wander / figure8 / square demo drives for filming
    - Tuning page: switch back to the old continuous turn to show the difference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
2026-11-06 Document the platform and the control system; add the car firmware
    - README rewritten around what RoboField is and does today, with real-car results
    - docs/control.md: the measured delay and motor data, and how each is handled
    - firmware/car_esp8266: the sketch the cars actually run (secrets.h ignored)
    - CLAUDE.md: current-state section at the top
    - Declare the mujoco dependency as the `sim` extra
2026-11-06 Race from random starts; RL sees the delay-predicted state; camera recorder
    - Race episodes start anywhere across the outer lane, facing any direction
    - RoboFieldEnv(predict=True) observes the same delay-predicted state as the real field
    - Parallel training (one process per env, each with its own randomization seed)
    - Real-car evaluation: speed scale keeps the turn ratio; aligning first is now optional
    - tools/record_camera.py records the Pi preview with its tracking overlay
    A 4M-step policy completes 3 laps from 10/10 random starts in sim (9/10 with
    randomized physics) and completed 3 laps on the real car at 60% speed.
2026-11-06 Saved moves, filming tools, before/after comparison runner
    - Control Center: save a drawn (or sketched) path as a named move in
    config/moves/, park the car at its start, replay it from its first point;
    STOP cancels a move still driving to its start
    - PoseController: decide "already there" by distance along the path, so a
    loop that ends where it starts is driven; set_path(nearest=False)
    - Web page: Moves panel, sketch-only drawing, ?caption= label for filming,
    camera image reconnects after a dropped stream
    - Server: ignore query strings on GET routes
    - tools/record_screen.py: record the page in headless Chrome (CDP screencast)
    - tools/record_camera.py: reconnect on a stalled stream, -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
2026-11-06 Add live tuning page, per-car wheel swap, and smoother final approach
    - /tuning web page: live sliders for 21 controller/motor parameters, save to config
    - Speed now ramps down toward the goal (slow_radius) instead of a late handoff
    - Per-robot wheels_swapped flag for this car's wiring, applied at the radio boundary
    - Gentler real-hardware gains and a realistic 6 deg orientation tolerance
    - Real-car RL evaluation path with Safety, alignment and speed scaling
    [field.yaml]
2026-11-06 Rebuild motion control around measured latency and motor response
    Measured on the real car: ~0.2 s command-to-camera delay (not 0.07), a
    minimum wheel speed of ~100 mm/s (the firmware's dead-zone floor), and an
    8% left/right speed mismatch. The laptop was also compensating the dead
    zone a second time on top of the firmware.
    - Smith predictor: replay the commands already in flight through the
    measured motor model, instead of extrapolating the last speed
    - DiffDrive maps speeds through the measured speed curve, with trim
    - Final heading: turn, stop, wait out the delay, then self-tuning nudges
    - Lines and curves: pure pursuit with accel, braking and curve speed limits
    - Simulator emulates th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
2026-11-06 Precise parking at a move's start; safer filming when the tracker drops
    - Parking at a move's start now goes to a point 12 cm behind it, then
    straight in, so the last turn on the spot is small (a big pivot shifted
    the car ~7 cm); exposed as "parking" in /api/state
    - Changing tuning mid-move ends that move instead of leaving a goal with
    no controller (KeyError in the control loop once the car reappeared)
    - film_move: refuse to start when the tracker is down or the car unseen,
    abort if parking misses, switch the controller only once recording,
    and always restore the "after" settings
    - record_camera: retry the Pi stream a few times before giving up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
